argokaz/3DprintGoga/switch2_visera/img/a1_diag.png

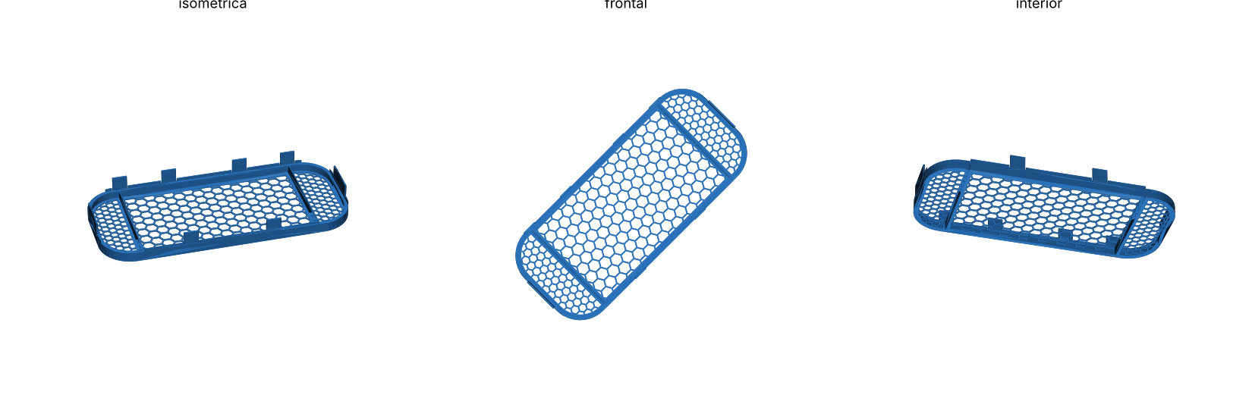
switch2_visera/img/a1_diag.png
