argokaz/3DprintGoga/switch2_visera/stl/full.stl

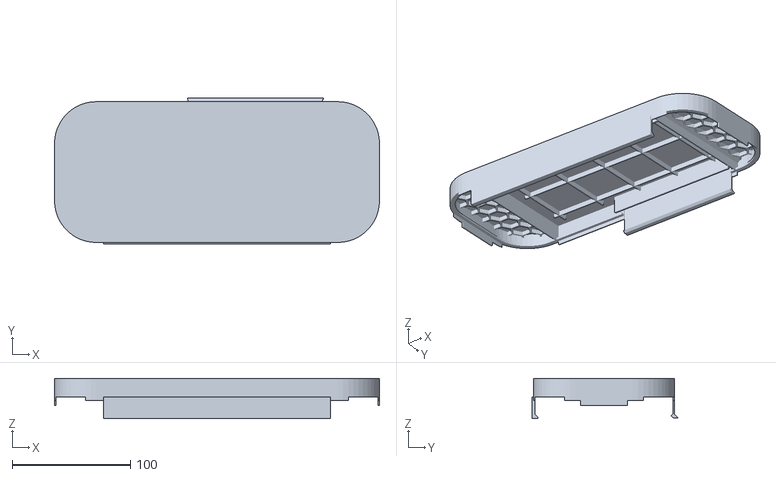
[picture p5: CAD file, 2026-10-30]
switch2_visera/stl/full.stl
275.2 x 123.4 x 33.9
