argokaz/3DprintGoga/switch2_visera/stl/test_grip.stl

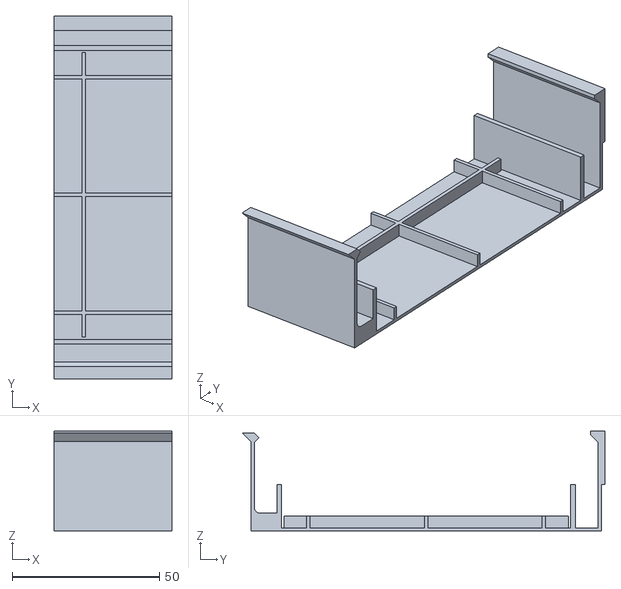
[picture p7: CAD file, 2026-10-30]
switch2_visera/stl/test_grip.stl
40.0 x 123.4 x 33.9
