argokaz/3DprintGoga/switch2_visera/visera_switch2_A1_PETG.3mf

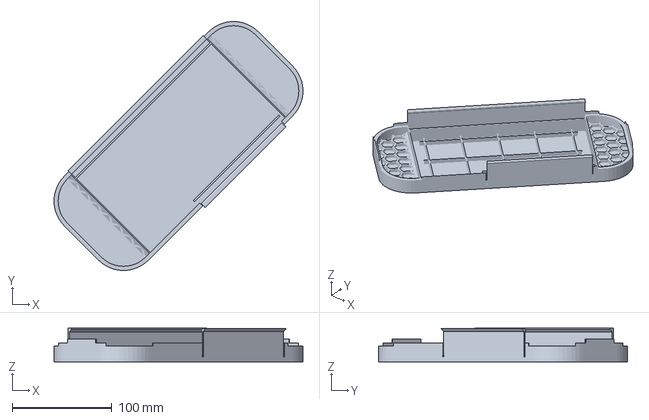
[picture p8: CAD file, 2026-10-30]
switch2_visera/visera_switch2_A1_PETG.3mf
249.6 x 249.6 x 33.9 mm
