argokaz/3DprintGoga/switch2_visera/stl/test_hood.stl

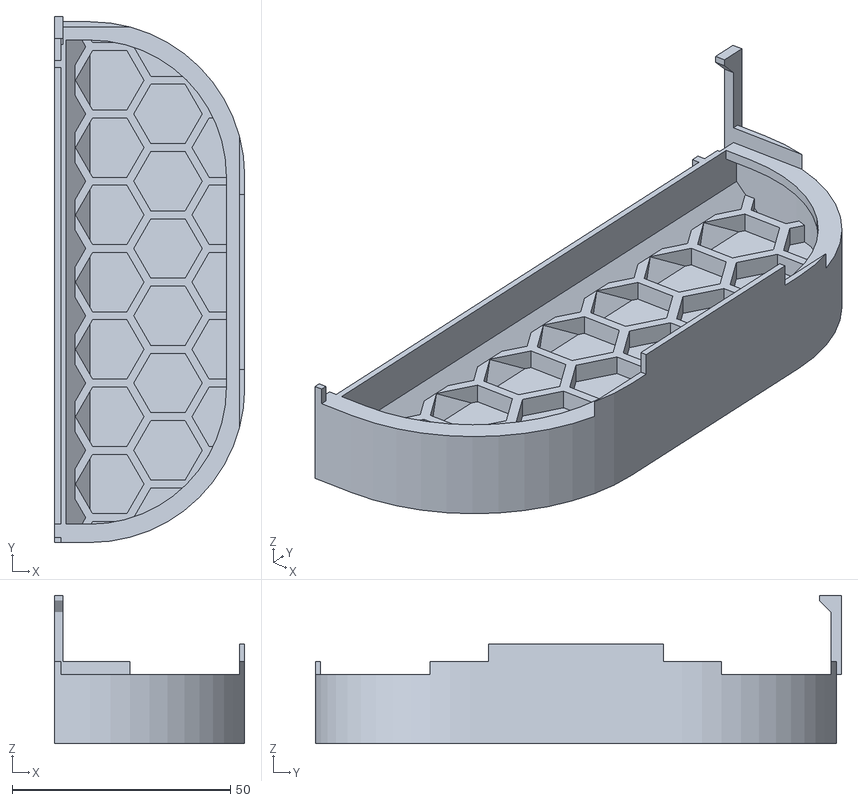
[picture p9: CAD file, 2026-10-30]
switch2_visera/stl/test_hood.stl
43.6 x 120.4 x 33.9
