argokaz/3DprintGoga/(list of files, cad)

Other CAD files:
switch2_visera/stl/a1_diag.stl
switch2_visera/visera_switch2_A1_PLA.3mf
