argokaz/3DprintGoga/switch2_visera/img/test_grip.png

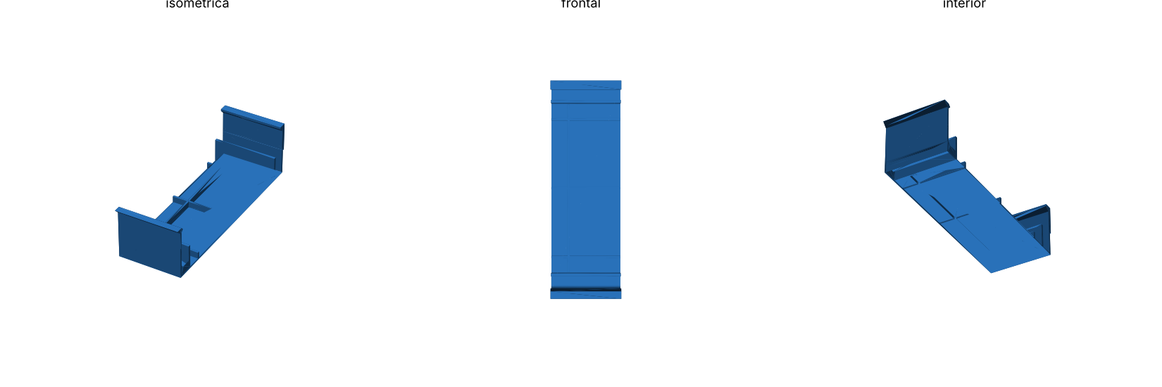
switch2_visera/img/test_grip.png
