argokaz/3DprintGoga/(commit log)

2026-10-29 Add parametric Switch 2 front visor (stick guard) prototype
    OpenSCAD model with full, split halves and test-fit parts, STL exports
    and preview renders.
    Claude-Session: https://claude.ai/code/session_01B7sJZ7NoR7y6aP8Wefjhot
    [full.stl, left.stl, right.stl, switch2_visera.scad, test_clip.stl, test_hood.stl]
2026-10-29 Apply researched Switch 2 dimensions and add README
    Joy-Con 2 visible width 35.5 mm, stick height 7.2 mm; documents sources,
    confidence levels and print settings.
    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
    [full.stl, left.stl, right.stl, switch2_visera.scad, test_clip.stl, test_hood.stl]
2026-10-29 Stronger PLA retention and Bambu A1 print plate
    Ten grip points: segmented fingers top/bottom plus wraps around the
    Joy-Con ends, with relief slots so each finger flexes safely in PLA.
    Adds a1_plate part with both halves face-down on a 256 mm bed.
    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
    [a1_plate.stl, full.stl, left.stl, right.stl, switch2_visera.scad, test_clip.stl, test_hood.stl]
2026-10-29 One-piece visor printed diagonally on a 256 mm bed
    Cover corners get a radius computed from the bed size so the whole
    visor fits rotated 45 degrees on the Bambu A1; adds a1_diag part and a
    top-view fit diagram, drops the split-half STLs.
    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
    [a1_diag.stl, a1_plate.stl, full.stl, left.stl, right.stl, switch2_visera.scad, test_clip.stl, test_hood.stl]
2026-10-29 FEA-driven redesign: longer snap fingers, ribbed screen panel, 3MF export
    - CalculiX/gmsh FEA pipeline (sim/fea.py) with snap-fit, point and crush cases
    - Fingers rooted near the top with fillet and relief holes (interlayer
    stress 20 -> 10.9 MPa in PLA)
    - Screen zone: solid skin + 8 mm deep hex core; solid 2 mm hoods, 4 mm
    stick clearance
    - Optional magnet pockets over the Joy-Con rail seam
    - tools/make_3mf.py builds Bambu Studio A1 project files (PLA / PETG)
    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
    [a1_diag.stl, full.stl, switch2_visera.scad, test_clip.stl, test_hood.stl, visera_switch2_A1_PETG.3mf, visera_switch2_A1_PLA.3mf]
2026-10-29 FEA: robust gmsh meshing, solver retry, simplified body for panel cases
    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
    [sim_body.stl]
2026-10-29 FEA: exact CAD sim body (OpenCASCADE) for panel load cases, run_all script
    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
    [sim_body.stl]
2026-10-29 Thicker screen skin (1.4 mm), simple-support BCs and direct solver in FEA
    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
    [a1_diag.stl, full.stl, switch2_visera.scad, test_clip.stl, test_hood.stl]
2026-10-29 Deeper ribbed panel with 45-degree rib ramps, adaptive FEA mesh
    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
    [a1_diag.stl, full.stl, switch2_visera.scad, test_clip.stl, test_hood.stl]
2026-10-29 Hood: shallow hex ribs under the ceiling and 45-degree wall gussets (FEA)
    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
    [a1_diag.stl, full.stl, switch2_visera.scad, test_hood.stl]
2026-10-29 Hood: 2.6 mm ceiling, 3.4 mm deep / 1.8 mm thick ribs (FEA round 6)
    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
    [a1_diag.stl, full.stl, switch2_visera.scad, test_clip.stl, test_hood.stl]
2026-10-29 Enlarge hood gusset to cover rib-bottom notch
    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
    [switch2_visera.scad]
2026-10-29 Final STLs and 3MFs for reinforced visor, README with structure and FEA method
    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
    [a1_diag.stl, full.stl, test_clip.stl, test_hood.stl, visera_switch2_A1_PETG.3mf, visera_switch2_A1_PLA.3mf]
2026-10-30 Grip v2: rigid bottom channel + wide top flap; fix cavity that erased hooks
    - Console cavity now stops at the back face (before, it removed every hook)
    - Bottom C-channel (rigid, 45-degree lip) and a single 115 mm top flap with
    tooth-shaped hook, root fillet and pull tab; end locating walls
    - Screen: thin solid skin (tempered glass already on the screen) + low ribs
    - Thinner perimeter walls; new test_grip part; flap_snap FEA case
    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
    [a1_diag.stl, full.stl, sim_grip.stl, switch2_visera.scad, test_clip.stl, test_grip.stl, test_hood.stl]
2026-10-30 Flap: 1.2 mm wall on a 6x8 mm beam; extruded-profile FEA for the grip strip
    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
    [full.stl, sim_grip.stl]
2026-10-30 Grip v2 validated: support feet, flap FEA (plane strain), final 3MFs and docs
    - Continuous support feet over the bezel along the flap and the channel
    - Flap: 9.1 MPa interlayer in PLA (2.7x), 6.0 MPa PETG (4.6x)
    - No rigid interference during the tilt-in install (2D kinematic check)
    - Light 1 mm screen skin; README rewritten with grip, usage and inspiration notes
    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
    [a1_diag.stl, full.stl, switch2_visera.scad, test_grip.stl, test_hood.stl, visera_switch2_A1_PETG.3mf, visera_switch2_A1_PLA.3mf]
2026-10-30 Add Switch 2 port/vent/control reference extracted from open-console-cad (MIT)
    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
